UrchinZ/LightMixing/README.md

# LightMixing

For Light Mixing Project

Project Website: http://bit.ly/1U50qnA
