UrchinZ/LightMixing/web/img/LESA.jpg

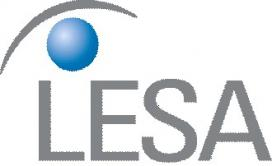
web/img/LESA.jpg
