UrchinZ/LightMixing/resource/design_files/Hardware/SensorMount_x1.stl

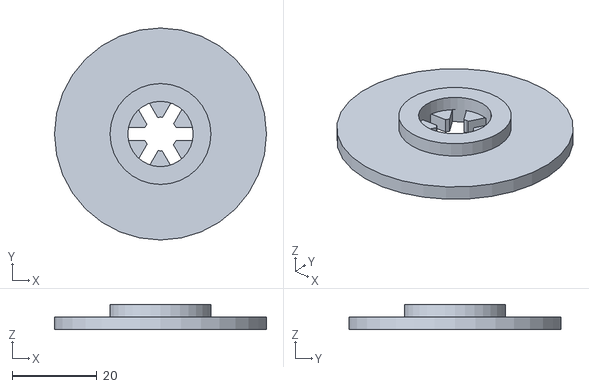
[picture p8: CAD file, 2016-06-10]
resource/design_files/Hardware/SensorMount_x1.stl
50.0 x 50.0 x 6.00
