UrchinZ/LightMixing/resource/design_files/Hardware/Base_x1.stl

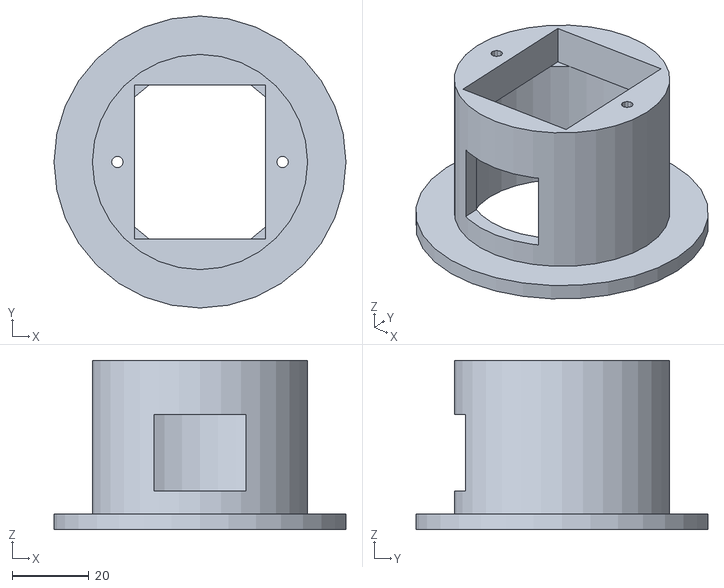
[picture p9: CAD file, 2016-06-10]
resource/design_files/Hardware/Base_x1.stl
76.0 x 76.0 x 44.0
