UrchinZ/LightMixing/resource/design_files/Sofware/Matlab_Arduino/light_mixing/calibration_data1.xlsx

R | G | B | A | V | W | C | R | G | B
0 | 0 | 0 | 0 | 0 | 0 | 1 | 0 | 0 | 0
0.1 | 0 | 0 | 0 | 0 | 0 | 135 | 123 | 9 | 13
0.2 | 0 | 0 | 0 | 0 | 0 | 268 | 248 | 20 | 28
0.3 | 0 | 0 | 0 | 0 | 0 | 400 | 370 | 30 | 42
0.4 | 0 | 0 | 0 | 0 | 0 | 532 | 493 | 40 | 56
0.5 | 0 | 0 | 0 | 0 | 0 | 663 | 615 | 50 | 70
0.6 | 0 | 0 | 0 | 0 | 0 | 795 | 737 | 60 | 85
0 | 0.1 | 0 | 0 | 0 | 0 | 83 | 11 | 58 | 16
0 | 0.2 | 0 | 0 | 0 | 0 | 167 | 22 | 118 | 34
0 | 0.3 | 0 | 0 | 0 | 0 | 249 | 33 | 179 | 51
0 | 0.4 | 0 | 0 | 0 | 0 | 332 | 43 | 239 | 68
0 | 0.5 | 0 | 0 | 0 | 0 | 415 | 54 | 298 | 86
0 | 0.6 | 0 | 0 | 0 | 0 | 497 | 65 | 358 | 103
0 | 0.7 | 0 | 0 | 0 | 0 | 580 | 76 | 418 | 122
0 | 0.8 | 0 | 0 | 0 | 0 | 663 | 87 | 478 | 140
0 | 0.9 | 0 | 0 | 0 | 0 | 746 | 98 | 538 | 157
0 | 0 | 0.1 | 0 | 0 | 0 | 109 | 1 | 35 | 81
0 | 0 | 0.2 | 0 | 0 | 0 | 215 | 3 | 71 | 164
0 | 0 | 0.3 | 0 | 0 | 0 | 322 | 4 | 108 | 245
0 | 0 | 0.4 | 0 | 0 | 0 | 428 | 5 | 144 | 327
0 | 0 | 0.5 | 0 | 0 | 0 | 535 | 7 | 179 | 409
0 | 0 | 0.6 | 0 | 0 | 0 | 642 | 8 | 215 | 491
0 | 0 | 0.7 | 0 | 0 | 0 | 749 | 9 | 251 | 573
0 | 0 | 0.8 | 0 | 0 | 0 | 856 | 11 | 287 | 655
0 | 0 | 0.9 | 0 | 0 | 0 | 963 | 12 | 323 | 737
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
